netsecdevio/NeoCalculator/docs/UNIT_CATALOG_02_INVENTORY.md

# Generated unit inventory

Source: `src/math/units/registry.json`. IDs do not depend on order.

| ID | Symbol | English / Español | Kind | SI nominal scale and offset | Exactness | Source / location |
|---|---|---|---|---|---|---|
| 1 | m | Metre / Metro | length | [1, 1, 0, 0] ; offset [0, 1, 0, 0] | exact | bipm: §2.3.1, metre |
| 2 | g | Gram / Gramo | mass | [1, 1, -3, 0] ; offset [0, 1, 0, 0] | exact | bipm: §3, p.139, kilogram exception |
| 3 | s | Second / Segundo | time | [1, 1, 0, 0] ; offset [0, 1, 0, 0] | exact | bipm: §2.3.1, second |
| 4 | A | Ampere / Amperio | current | [1, 1, 0, 0] ; offset [0, 1, 0, 0] | exact | bipm: §2.3.1, ampere |
| 5 | K | Kelvin / Kelvin | temperature | [1, 1, 0, 0] ; offset [0, 1, 0, 0] | exact | bipm: §2.3.1, kelvin |
| 6 | mol | Mole / Mol | amount | [1, 1, 0, 0] ; offset [0, 1, 0, 0] | exact | bipm: §2.3.1, mole |
| 7 | cd | Candela / Candela | luminous_intensity | [1, 1, 0, 0] ; offset [0, 1, 0, 0] | exact | bipm: §2.3.1, candela |
| 8 | rad | Radian / Radián | angle | [1, 1, 0, 0] ; offset [0, 1, 0, 0] | exact | bipm: §2.3.4, Table 4 |
| 9 | sr | Steradian / Estereorradián | solid_angle | [1, 1, 0, 0] ; offset [0, 1, 0, 0] | exact | bipm: §2.3.4, Table 4 |
| 10 | Hz | Hertz / Hercio | frequency | [1, 1, 0, 0] ; offset [0, 1, 0, 0] | exact | bipm: §2.3.4, Table 4 |
| 11 | N | Newton / Newton | force | [1, 1, 0, 0] ; offset [0, 1, 0, 0] | exact | bipm: §2.3.4, Table 4 |
| 12 | Pa | Pascal / Pascal | pressure | [1, 1, 0, 0] ; offset [0, 1, 0, 0] | exact | bipm: §2.3.4, Table 4 |
| 13 | J | Joule / Julio | energy | [1, 1, 0, 0] ; offset [0, 1, 0, 0] | exact | bipm: §2.3.4, Table 4 |
| 14 | W | Watt / Vatio | power | [1, 1, 0, 0] ; offset [0, 1, 0, 0] | exact | bipm: §2.3.4, Table 4 |
| 15 | C | Coulomb / Culombio | charge | [1, 1, 0, 0] ; offset [0, 1, 0, 0] | exact | bipm: §2.3.4, Table 4 |
| 16 | V | Volt / Voltio | voltage | [1, 1, 0, 0] ; offset [0, 1, 0, 0] | exact | bipm: §2.3.4, Table 4 |
| 17 | F | Farad / Faradio | capacitance | [1, 1, 0, 0] ; offset [0, 1, 0, 0] | exact | bipm: §2.3.4, Table 4 |
| 18 | Ω | Ohm / Ohmio | resistance | [1, 1, 0, 0] ; offset [0, 1, 0, 0] | exact | bipm: §2.3.4, Table 4 |
| 19 | S | Siemens / Siemens | conductance | [1, 1, 0, 0] ; offset [0, 1, 0, 0] | exact | bipm: §2.3.4, Table 4 |
| 20 | Wb | Weber / Weber | magnetic_flux | [1, 1, 0, 0] ; offset [0, 1, 0, 0] | exact | bipm: §2.3.4, Table 4 |
| 21 | T | Tesla / Tesla | flux_density | [1, 1, 0, 0] ; offset [0, 1, 0, 0] | exact | bipm: §2.3.4, Table 4 |
| 22 | H | Henry / Henrio | inductance | [1, 1, 0, 0] ; offset [0, 1, 0, 0] | exact | bipm: §2.3.4, Table 4 |
| 23 | °C | Degree Celsius / Grado Celsius | temperature | [1, 1, 0, 0] ; offset [27315, 100, 0, 0] | exact | bipm: §2.3.4, Table 4 |
| 24 | lm | Lumen / Lumen | luminous_flux | [1, 1, 0, 0] ; offset [0, 1, 0, 0] | exact | bipm: §2.3.4, Table 4 |
| 25 | lx | Lux / Lux | illuminance | [1, 1, 0, 0] ; offset [0, 1, 0, 0] | exact | bipm: §2.3.4, Table 4 |
| 26 | Bq | Becquerel / Becquerel | activity | [1, 1, 0, 0] ; offset [0, 1, 0, 0] | exact | bipm: §2.3.4, Table 4 |
| 27 | Gy | Gray / Gray | absorbed_dose | [1, 1, 0, 0] ; offset [0, 1, 0, 0] | exact | bipm: §2.3.4, Table 4 |
| 28 | Sv | Sievert / Sievert | equivalent_dose | [1, 1, 0, 0] ; offset [0, 1, 0, 0] | exact | bipm: §2.3.4, Table 4 |
| 29 | kat | Katal / Katal | catalytic_activity | [1, 1, 0, 0] ; offset [0, 1, 0, 0] | exact | bipm: §2.3.4, Table 4 |
| 40 | in | Inch (international) / Pulgada internacional | length | [254, 1, -4, 0] ; offset [0, 1, 0, 0] | exact | nist811: Appendix B.8, named row; exact definition |
| 41 | ft | Foot (international) / Pie internacional | length | [3048, 1, -4, 0] ; offset [0, 1, 0, 0] | exact | nist811: Appendix B.8, named row; exact definition |
| 42 | yd | Yard (international) / Yarda internacional | length | [9144, 1, -4, 0] ; offset [0, 1, 0, 0] | exact | nist811: Appendix B.8, named row; exact definition |
| 43 | mi | Mile (international) / Milla internacional | length | [1609344, 1, -3, 0] ; offset [0, 1, 0, 0] | exact | nist811: Appendix B.8, named row; exact definition |
| 44 | nmi | Nautical mile / Milla náutica | length | [1852, 1, 0, 0] ; offset [0, 1, 0, 0] | exact | bipm: §4, Table 8, pp.140–141 |
| 45 | ha | Hectare / Hectárea | area | [1, 1, 4, 0] ; offset [0, 1, 0, 0] | exact | bipm: §4, Table 8, pp.140–141 |
| 46 | L | Litre / Litro | volume | [1, 1, -3, 0] ; offset [0, 1, 0, 0] | exact | bipm: §4, Table 8, pp.140–141 |
| 47 | min | Minute / Minuto | time | [60, 1, 0, 0] ; offset [0, 1, 0, 0] | exact | bipm: §4, Table 8, pp.140–141 |
| 48 | h | Hour / Hora | time | [3600, 1, 0, 0] ; offset [0, 1, 0, 0] | exact | bipm: §4, Table 8, pp.140–141 |
| 49 | d | Day / Día | time | [86400, 1, 0, 0] ; offset [0, 1, 0, 0] | exact | bipm: §4, Table 8, pp.140–141 |
| 50 | lb | Pound (avoirdupois) / Libra avoirdupois | mass | [45359237, 1, -8, 0] ; offset [0, 1, 0, 0] | exact | nist811: Appendix B.8, named row; exact definition |
| 51 | oz | Ounce (avoirdupois) / Onza avoirdupois | mass | [45359237, 16, -8, 0] ; offset [0, 1, 0, 0] | exact | nist811: Appendix B.8, named row; exact definition |
| 52 | t | Tonne / Tonelada | mass | [1, 1, 3, 0] ; offset [0, 1, 0, 0] | exact | bipm: §4, Table 8, pp.140–141 |
| 53 | atm | Standard atmosphere / Atmósfera estándar | pressure | [101325, 1, 0, 0] ; offset [0, 1, 0, 0] | exact | nist811: Appendix B.8, named row; exact definition |
| 54 | bar | Bar / Bar | pressure | [1, 1, 5, 0] ; offset [0, 1, 0, 0] | exact | bipm: §4, Table 8, pp.140–141 |
| 55 | psi | Pound-force per square inch / Libra-fuerza por pulgada cuadrada | pressure | [8896443230521, 1290320000, 0, 0] ; offset [0, 1, 0, 0] | exact | nist811: B.8 pound-force and inch; BIPM Appendix CGPM 1901, standard g |
| 56 | eV | Electronvolt / Electronvoltio | energy | [1602176634, 1, -28, 0] ; offset [0, 1, 0, 0] | exact | bipm: §4, Table 8, pp.140–141 |
| 57 | ° | Degree / Grado angular | angle | [1, 180, 0, 1] ; offset [0, 1, 0, 0] | exact | bipm: §4, Table 8, pp.140–141 |
| 58 | ′ | Arcminute / Minuto de arco | angle | [1, 10800, 0, 1] ; offset [0, 1, 0, 0] | exact | bipm: §4, Table 8, pp.140–141 |
| 59 | ″ | Arcsecond / Segundo de arco | angle | [1, 648000, 0, 1] ; offset [0, 1, 0, 0] | exact | bipm: §4, Table 8, pp.140–141 |
| 60 | °F | Degree Fahrenheit / Grado Fahrenheit | temperature | [5, 9, 0, 0] ; offset [45967, 180, 0, 0] | exact | nist_temperature: Exact conversion equations, Fahrenheit to kelvin |
| 61 | ΔK | Kelvin difference / Diferencia kelvin | temperature | [1, 1, 0, 0] ; offset [0, 1, 0, 0] | exact | nist_temperature: Temperature intervals |
| 62 | Δ°C | Celsius difference / Diferencia Celsius | temperature | [1, 1, 0, 0] ; offset [0, 1, 0, 0] | exact | nist_temperature: Temperature intervals |
| 63 | Δ°F | Fahrenheit difference / Diferencia Fahrenheit | temperature | [5, 9, 0, 0] ; offset [0, 1, 0, 0] | exact | nist_temperature: Temperature intervals |
| 64 | au | Astronomical unit / Unidad astronómica | length | [149597870700, 1, 0, 0] ; offset [0, 1, 0, 0] | exact | bipm: §4, Table 8, pp.140–141 |
| 65 | lbf | Pound-force / Libra-fuerza | force | [8896443230521, 2000000000000, 0, 0] ; offset [0, 1, 0, 0] | exact | nist811: B.8 pound-force; BIPM Appendix CGPM 1901, standard g |
| 1006 | mil | Mil / thou / Mil / thou | length | [127, 5, -6, 0] ; offset [0, 1, 0, 0] | exact | ucum22: [mil_i] |
| 1008 | ftm | International fathom / Braza internacional | length | [1143, 625, 0, 0] ; offset [0, 1, 0, 0] | exact | ucum22: [fth_i] |
| 1009 | cable | Cable (0.1 nmi) / Cable (0,1 nmi) | length | [926, 5, 0, 0] ; offset [0, 1, 0, 0] | exact | nist_foot: cable length185.2m |
| 1010 | cableUS | Cable (US, 720 ft) / Cable (EE. UU., 720 ft) | length | [27432, 125, 0, 0] ; offset [0, 1, 0, 0] | exact | nist_foot: cable720internationalfeet |
| 1011 | ch | International chain / Cadena internacional | length | [12573, 625, 0, 0] ; offset [0, 1, 0, 0] | exact | nist_foot: International foot-based relation; 66ft |
| 1012 | link | International link / Eslabón internacional | length | [12573, 625, -2, 0] ; offset [0, 1, 0, 0] | exact | nist_foot: International foot-based relation; 33/50ft |
| 1013 | rd | International rod / Rod internacional | length | [12573, 25, -2, 0] ; offset [0, 1, 0, 0] | exact | nist_foot: International foot-based relation; 33/2ft |
| 1014 | fur | International furlong / Furlong internacional | length | [25146, 125, 0, 0] ; offset [0, 1, 0, 0] | exact | nist_foot: International foot-based relation; 660ft |
| 1015 | hand | Equestrian hand / Mano ecuestre | length | [127, 125, -1, 0] ; offset [0, 1, 0, 0] | exact | ucum22: International foot-based relation; 1/3ft |
| 1016 | ft | US survey foot (historic) / Pie topográfico EE. UU. | length | [12, 3937, 2, 0] ; offset [0, 1, 0, 0] | exact | nist_foot: US survey foot1200/3937m; obsolete after2022 |
| 1018 | ly | Light-year (Julian) / Año luz (juliano) | length | [94607304725808, 1, 2, 0] ; offset [0, 1, 0, 0] | exact | ucum22: [ly]=[c].a_j |
| 1019 | pc | Parsec / Pársec | length | [969394202136, 1, 5, -1] ; offset [0, 1, 0, 0] | exact | iau2015: Note4 exact648000au/pi |
| 1020 | ls | Light-second / Segundo luz | length | [299792458, 1, 0, 0] ; offset [0, 1, 0, 0] | exact | bipm: Defining speed of light times1second |
| 1021 | Å | Angstrom / Ángstrom | length | [1, 1, -10, 0] ; offset [0, 1, 0, 0] | exact | nist811: angstrom |
| 1022 | pt | DTP point / Punto DTP | length | [127, 36, -4, 0] ; offset [0, 1, 0, 0] | exact | css4: Absolute length:1pt=1/72in |
| 1023 | pc | DTP pica / Pica DTP | length | [127, 3, -4, 0] ; offset [0, 1, 0, 0] | exact | css4: Absolute length:1pc=1/6in |
| 1024 | U | Rack unit / Unidad de rack | length | [889, 2, -4, 0] ; offset [0, 1, 0, 0] | exact | rack: Nominal1.75in rack height |
| 1025 | Fr | French / Charriere / French / Charrière | length | [1, 3, -3, 0] ; offset [0, 1, 0, 0] | exact | ucum22: [Ch]=mm/3; diameter, not area |
| 1027 | a | Are / Área | area | [1, 1, 2, 0] ; offset [0, 1, 0, 0] | exact | nist811: are100m²; hectare remains stable existing identity |
| 1029 | ac | International acre / Acre internacional | area | [316160658, 78125, 0, 0] ; offset [0, 1, 0, 0] | exact | nist_foot: International acre43560ft² |
| 1034 | b | Barn / Barnio | area | [1, 1, -28, 0] ; offset [0, 1, 0, 0] | exact | nist811: barn |
| 1035 | cmil | Circular mil / Circular mil | area | [16129, 1, -14, 1] ; offset [0, 1, 0, 0] | exact | ucum22: [cml_i]=pi/4*[mil_i]^2 |
| 1041 | gal | US liquid gallon / Galón líquido EE. UU. | volume | [473176473, 125, -9, 0] ; offset [0, 1, 0, 0] | exact | ucum22: [gal_us]=231in³ |
| 1042 | gal | Imperial gallon / Galón imperial | volume | [454609, 1, -8, 0] ; offset [0, 1, 0, 0] | exact | ucum22: [gal_br]=4.54609L |
| 1043 | qt | US liquid quart / Cuarto líquido EE. UU. | volume | [473176473, 5, -11, 0] ; offset [0, 1, 0, 0] | exact | ucum22: [qt_us] |
| 1044 | qt | Imperial quart / Cuarto imperial | volume | [454609, 4, -8, 0] ; offset [0, 1, 0, 0] | exact | ucum22: [qt_br] |
| 1045 | pt | US liquid pint / Pinta líquida EE. UU. | volume | [473176473, 1, -12, 0] ; offset [0, 1, 0, 0] | exact | ucum22: [pt_us] |
| 1046 | pt | Imperial pint / Pinta imperial | volume | [454609, 8, -8, 0] ; offset [0, 1, 0, 0] | exact | ucum22: [pt_br] |
| 1047 | fl oz | US fluid ounce / Onza líquida EE. UU. | volume | [473176473, 16, -12, 0] ; offset [0, 1, 0, 0] | exact | ucum22: [foz_us] |
| 1048 | fl oz | Imperial fluid ounce / Onza líquida imperial | volume | [454609, 16, -9, 0] ; offset [0, 1, 0, 0] | exact | ucum22: [foz_br] |
| 1049 | gi | US gill / Gill EE. UU. | volume | [473176473, 4, -12, 0] ; offset [0, 1, 0, 0] | exact | ucum22: [gil_us] |
| 1050 | gi | Imperial gill / Gill imperial | volume | [454609, 32, -8, 0] ; offset [0, 1, 0, 0] | exact | ucum22: [gil_br] |
| 1051 | gal | US dry gallon / Galón áridos EE. UU. | volume | [220244188543, 5, -13, 0] ; offset [0, 1, 0, 0] | exact | ucum22: [gal_wi]=[bu_us]/8 |
| 1052 | qt | US dry quart / Cuarto áridos EE. UU. | volume | [220244188543, 2, -14, 0] ; offset [0, 1, 0, 0] | exact | ucum22: [dqt_us] |
| 1053 | pt | US dry pint / Pinta áridos EE. UU. | volume | [220244188543, 4, -14, 0] ; offset [0, 1, 0, 0] | exact | ucum22: [dpt_us] |
| 1054 | bu | US bushel / Bushel EE. UU. | volume | [220244188543, 625, -10, 0] ; offset [0, 1, 0, 0] | exact | ucum22: [bu_us]=2150.42in³ |
| 1055 | bu | Imperial bushel / Bushel imperial | volume | [454609, 125, -5, 0] ; offset [0, 1, 0, 0] | exact | ucum22: [bu_br] |
| 1056 | pk | US peck / Peck EE. UU. | volume | [220244188543, 25, -12, 0] ; offset [0, 1, 0, 0] | exact | ucum22: [pk_us] |
| 1057 | pk | Imperial peck / Peck imperial | volume | [454609, 5, -7, 0] ; offset [0, 1, 0, 0] | exact | ucum22: [pk_br] |
| 1058 | bbl | Petroleum barrel / Barril de petróleo | volume | [9936705933, 625, -8, 0] ; offset [0, 1, 0, 0] | exact | ucum22: [bbl_us] |
| 1060 | board ft | Board foot / Pie tablar | volume | [18435447, 78125, -5, 0] ; offset [0, 1, 0, 0] | exact | ucum22: [bf_i]=144in³ |
| 1061 | cord | Cord (stacked wood) / Cord (madera apilada) | volume | [884901456, 244140625, 0, 0] ; offset [0, 1, 0, 0] | exact | ucum22: [cr_i] |
| 1062 | st | Stere (stacked wood) / Estéreo (madera apilada) | volume | [1, 1, 0, 0] ; offset [0, 1, 0, 0] | exact | ucum22: st |
| 1063 | register ton | Register ton (volume) / Tonelada de registro | volume | [55306341, 1953125, -1, 0] ; offset [0, 1, 0, 0] | exact | nist811: NIST register ton100ft³ |
| 1064 | tsp | US teaspoon / Cucharadita EE. UU. | cooking_volume | [157725491, 32, -12, 0] ; offset [0, 1, 0, 0] | exact | ucum22: [tsp_us] |
| 1065 | tbsp | US tablespoon / Cucharada EE. UU. | cooking_volume | [473176473, 32, -12, 0] ; offset [0, 1, 0, 0] | exact | ucum22: [tbs_us] |
| 1066 | cup | US customary cup / Taza habitual EE. UU. | cooking_volume | [473176473, 2, -12, 0] ; offset [0, 1, 0, 0] | exact | ucum22: [cup_us] |
| 1067 | tsp | Metric teaspoon (5mL) / Cucharadita métrica (5mL) | cooking_volume | [1, 2, -5, 0] ; offset [0, 1, 0, 0] | exact | fda1019: b5viii5mL convention |
| 1068 | tbsp | Metric tablespoon (15mL) / Cucharada métrica (15mL) | cooking_volume | [3, 2, -5, 0] ; offset [0, 1, 0, 0] | exact | fda1019: b5viii15mL convention |
| 1069 | tbsp | Australian tablespoon / Cucharada australiana | cooking_volume | [1, 5, -4, 0] ; offset [0, 1, 0, 0] | exact | cooking_au: Australian20mL convention |
| 1070 | cup | Metric cup (250mL) / Taza métrica (250mL) | cooking_volume | [1, 4, -3, 0] ; offset [0, 1, 0, 0] | exact | cooking_au: Metric250mL convention |
| 1071 | cup | FDA nutrition cup (240mL) / Taza FDA (240mL) | cooking_volume | [3, 125, -2, 0] ; offset [0, 1, 0, 0] | exact | fda1019: b5viii240mL |
| 1076 | wk | Week (7 days) / Semana (7 días) | time | [6048, 1, 2, 0] ; offset [0, 1, 0, 0] | exact | ucum22: wk=7d |
| 1077 | a | Julian year / Año juliano | time | [315576, 1, 2, 0] ; offset [0, 1, 0, 0] | exact | ucum22: a_j=365.25d |
| 1078 | shake | Shake / Shake | time | [1, 1, -8, 0] ; offset [0, 1, 0, 0] | exact | nist811: shake |
| 1083 | gon | Gon / gradian / Gon / grado centesimal | plane_angle | [1, 2, -2, 1] ; offset [0, 1, 0, 0] | exact | ucum22: gon |
| 1084 | rev | Revolution / turn / Vuelta / revolución | plane_angle | [2, 1, 0, 1] ; offset [0, 1, 0, 0] | exact | ucum22: circ=2pi rad |
| 1086 | deg² | Square degree (solid angle) / Grado cuadrado (ángulo sólido) | solid_angle | [1, 324, -2, 2] ; offset [0, 1, 0, 0] | exact | bipm: sr=rad²; (pi/180)²sr |
| 1090 | st | Stone (mass) / Stone (masa) | mass | [317514659, 5, -7, 0] ; offset [0, 1, 0, 0] | exact | ucum22: [stone_av] |
| 1091 | gr | Grain / Grano | mass | [6479891, 1, -11, 0] ; offset [0, 1, 0, 0] | exact | ucum22: [gr] |
| 1092 | ct | Metric carat / Quilate métrico | mass | [1, 5, -3, 0] ; offset [0, 1, 0, 0] | exact | ucum22: [car_m] |
| 1093 | ozt | Troy ounce / Onza troy | mass | [19439673, 625, -6, 0] ; offset [0, 1, 0, 0] | exact | ucum22: [oz_tr] |
| 1094 | lb t | Troy pound / Libra troy | mass | [58319019, 15625, -4, 0] ; offset [0, 1, 0, 0] | exact | ucum22: [lb_tr] |
| 1095 | dwt | Pennyweight / Pennyweight | mass | [19439673, 125, -8, 0] ; offset [0, 1, 0, 0] | exact | ucum22: [pwt_tr] |
| 1097 | sh tn | US short ton / Tonelada corta EE. UU. | mass | [45359237, 5, -4, 0] ; offset [0, 1, 0, 0] | exact | ucum22: [ston_av] |
| 1098 | lg tn | Imperial long ton / Tonelada larga imperial | mass | [317514659, 3125, -2, 0] ; offset [0, 1, 0, 0] | exact | ucum22: [lton_av] |
| 1099 | cwt | US hundredweight / Hundredweight EE. UU. | mass | [45359237, 1, -6, 0] ; offset [0, 1, 0, 0] | exact | ucum22: [scwt_av] |
| 1100 | cwt | Imperial hundredweight / Hundredweight imperial | mass | [317514659, 625, -4, 0] ; offset [0, 1, 0, 0] | exact | ucum22: [lcwt_av] |
| 1101 | q | Metric quintal (100kg) / Quintal métrico (100kg) | mass | [1, 1, 2, 0] ; offset [0, 1, 0, 0] | exact | nist811: 100kg named convention |
| 1102 | slug | Slug / Slug | mass | [8896443230521, 6096, -8, 0] ; offset [0, 1, 0, 0] | exact | nist811: lbf*s²/ft |
| 1103 | Da | Dalton / unified atomic mass / Dalton / masa atómica unificada | mass | [41513476723, 25, -36, 0] ; offset [0, 1, 0, 0] | measured | codata2022: atomic mass constant2022 |
| 1104 | eV/c² | Electronvolt per c squared / Electronvoltio dividido por c² | mass | [1602176634, 89875517873681764, -28, 0] ; offset [0, 1, 0, 0] | exact | bipm: eV/c² using exact c and elementary charge |
| 1114 | Gal | Gal / galileo / Gal / galileo | acceleration | [1, 1, -2, 0] ; offset [0, 1, 0, 0] | exact | ucum22: Gal=cm/s² |
| 1121 | dyn | Dyne / Dina | force | [1, 1, -5, 0] ; offset [0, 1, 0, 0] | exact | ucum22: dyn=g*cm/s² |
| 1122 | gf | Gram-force / Gramo-fuerza | force | [196133, 2, -7, 0] ; offset [0, 1, 0, 0] | exact | ucum22: gf=g*standard gravity |
| 1124 | ozf | Ounce-force / Onza-fuerza | force | [8896443230521, 32, -12, 0] ; offset [0, 1, 0, 0] | exact | ucum22: lbf/16 |
| 1125 | pdl | Poundal / Poundal | force | [17281869297, 125, -9, 0] ; offset [0, 1, 0, 0] | exact | ucum22: lb*ft/s² |
| 1126 | kip | Kip (1000lbf) / Kip (1000lbf) | force | [8896443230521, 2, -9, 0] ; offset [0, 1, 0, 0] | exact | nist811: kip1000lbf |
| 1127 | tf | Metric tonne-force / Tonelada-fuerza métrica | force | [196133, 2, -1, 0] ; offset [0, 1, 0, 0] | exact | nist811: 1000kgf |
| 1145 | at | Technical atmosphere / Atmósfera técnica | pressure | [196133, 2, 0, 0] ; offset [0, 1, 0, 0] | exact | ucum22: att=kgf/cm² |
| 1146 | Torr | Torr / Torr | pressure | [20265, 152, 0, 0] ; offset [0, 1, 0, 0] | exact | nist811: torr=atm/760 |
| 1147 | mmHg | Conventional millimetre Hg / Milímetro Hg convencional | pressure | [26664477483, 2, -8, 0] ; offset [0, 1, 0, 0] | exact | cldr_units: NIST B8 note12 + CLDR density13595.1kg/m³ and g_n; height1mm |
| 1148 | mH₂O | Conventional metre water / Metro agua convencional | pressure | [196133, 2, -1, 0] ; offset [0, 1, 0, 0] | exact | ucum22: m[H2O]=9.80665kPa |
| 1149 | inH₂O | Conventional inch water / Pulgada agua convencional | pressure | [24908891, 1, -5, 0] ; offset [0, 1, 0, 0] | exact | ucum22: [in_i'H2O] |
| 1150 | inHg | Conventional inch Hg / Pulgada Hg convencional | pressure | [3386388640341, 1, -9, 0] ; offset [0, 1, 0, 0] | exact | cldr_units: NIST B8 note12 + CLDR density13595.1kg/m³ and g_n; height1in |
| 1153 | Ba | Barye / Baria | pressure | [1, 1, -1, 0] ; offset [0, 1, 0, 0] | exact | nist811: dyn/cm² |
| 1156 | cal | Calorie (thermochemical) / Caloría termoquímica | energy | [523, 125, 0, 0] ; offset [0, 1, 0, 0] | exact | ucum22: cal_th=4.184J |
| 1157 | cal | Calorie (International Table) / Caloría Tabla Internacional | energy | [10467, 25, -2, 0] ; offset [0, 1, 0, 0] | exact | ucum22: cal_IT=4.1868J |
| 1158 | Btu_IT | Btu International Table / Btu Tabla Internacional | energy | [52752792631, 5, -7, 0] ; offset [0, 1, 0, 0] | exact | ucum22: [Btu_IT]=1.05505585262kJ |
| 1159 | Btu_th | Btu thermochemical / Btu termoquímica | energy | [23722880951, 225, -5, 0] ; offset [0, 1, 0, 0] | exact | nist811_notes: Footnote9: thermochemical calorie4.184J, pound453.59237g, Fahrenheit interval5/9K; exact relation |
| 1160 | erg | Erg / Ergio | energy | [1, 1, -7, 0] ; offset [0, 1, 0, 0] | exact | ucum22: erg=dyn*cm |
| 1163 | therm | Therm (US) / Therm (EE. UU.) | energy | [1054804, 1, 2, 0] ; offset [0, 1, 0, 0] | exact | nist811: B8 thermUS exact bold factor |
| 1164 | therm | Therm (EC) / Therm (CE) | energy | [105506, 1, 3, 0] ; offset [0, 1, 0, 0] | exact | nist811: B8 thermEC exact bold factor |
| 1165 | toe | Tonne oil equivalent / Tonelada equivalente petróleo | energy | [41868, 1, 6, 0] ; offset [0, 1, 0, 0] | exact | energy_uk: AnnexA statistical41.868GJ |
| 1166 | t TNT | Tonne TNT equivalent / Tonelada equivalente TNT | energy | [4184, 1, 6, 0] ; offset [0, 1, 0, 0] | exact | nist811: B8 tonTNT=4.184GJ |
| 1168 | hp | Mechanical horsepower / Horsepower mecánico | power | [37284993579113511, 5, -13, 0] ; offset [0, 1, 0, 0] | exact | ucum22: [HP]=550ft*lbf/s |
| 1169 | CV | Metric horsepower / Caballo de vapor métrico | power | [588399, 8, -2, 0] ; offset [0, 1, 0, 0] | exact | nist811: 75kgf*m/s |
| 1170 | hp | Electric horsepower (746W) / Horsepower eléctrico (746W) | power | [746, 1, 0, 0] ; offset [0, 1, 0, 0] | exact | nist811: B8 exact electrical horsepower746W |
| 1171 | hp | Boiler horsepower / Horsepower de caldera | power | [19619, 2, 0, 0] ; offset [0, 1, 0, 0] | conventional_approximate | nist811: B8 rounded boiler hp9809.50W |
| 1173 | TR | US refrigeration ton / Tonelada refrigeración EE. UU. | power | [52752792631, 15, -6, 0] ; offset [0, 1, 0, 0] | exact | nist811: 12000Btu_IT/h |
| 1176 | var | Var (reactive power) / Var (potencia reactiva) | reactive_power | [1, 1, 0, 0] ; offset [0, 1, 0, 0] | exact | bipm: Special name for reactive power; same SI dimension asW |
| 1180 | °R | Degree Rankine / Grado Rankine | temperature | [5, 9, 0, 0] ; offset [0, 1, 0, 0] | exact | ucum22: [degR]=5K/9 |
| 1181 | °Ré | Degree Reaumur / Grado Réaumur | temperature | [5, 4, 0, 0] ; offset [5463, 2, -1, 0] | exact | ucum22: [degRe] scale5/4K origin273.15K |
| 1190 | clo | Clo / Clo | thermal_insulance | [31, 2, -2, 0] ; offset [0, 1, 0, 0] | exact | nist811: B8 clo0.155m²K/W |
| 1191 | tog | Tog / Tog | thermal_insulance | [1, 1, -1, 0] ; offset [0, 1, 0, 0] | exact | tog_iom: tog |
| 1202 | tex | Tex / Tex | linear_mass | [1, 1, -6, 0] ; offset [0, 1, 0, 0] | exact | ucum22: tex=g/km |
| 1203 | den | Denier / Denier | linear_mass | [1, 9, -6, 0] ; offset [0, 1, 0, 0] | exact | ucum22: [den]=g/(9000m) |
| 1214 | P | Poise / Poise | dynamic_viscosity | [1, 1, -1, 0] ; offset [0, 1, 0, 0] | exact | ucum22: P=dyn*s/cm² |
| 1216 | St | Stokes / Stokes | kinematic_viscosity | [1, 1, -4, 0] ; offset [0, 1, 0, 0] | exact | ucum22: St=cm²/s |
| 1221 | D | Darcy (porous permeability) / Darcy (permeabilidad porosa) | permeability_porous | [1, 101325, -7, 0] ; offset [0, 1, 0, 0] | exact | usgs_darcy: p9: flow1cm³/s through1cm² of1cP fluid over1cm under1atm |
| 1238 | D | Debye (electric dipole) / Debye (dipolo eléctrico) | electric_dipole | [3335641, 1, -36, 0] ; offset [0, 1, 0, 0] | conventional_approximate | iupac_green: p18,40: debye approximate SI correspondence; no post2019 exact CGS conversion is asserted |
| 1240 | G | Gauss / Gauss | magnetic_flux_density | [1, 1, -4, 0] ; offset [0, 1, 0, 0] | exact | ucum22: G=1e-4T |
| 1242 | Mx | Maxwell / Maxwell | magnetic_flux | [1, 1, -8, 0] ; offset [0, 1, 0, 0] | exact | ucum22: Mx=1e-8Wb |
| 1244 | Oe | Oersted / Oersted | magnetic_field | [25, 1, 1, -1] ; offset [0, 1, 0, 0] | exact | ucum22: Oe=250/pi A/m |
| 1245 | A turn | Ampere turn (coil count) / Amperio vuelta (bobina) | magnetomotive_force | [1, 1, 0, 0] ; offset [0, 1, 0, 0] | exact | bipm: Coil-turn count is dimensionless; this is not angle rad/rev |
| 1246 | Gi | Gilbert / Gilbert | magnetomotive_force | [5, 2, 0, -1] ; offset [0, 1, 0, 0] | exact | ucum22: Gb=Oe*cm=2.5/pi A |
| 1250 | lbmol | Pound mole / Libra mol | amount | [45359237, 1, -5, 0] ; offset [0, 1, 0, 0] | exact | nist811: B8 pound-mole453.59237mol |
| 1258 | U | Enzyme activity unit / Unidad de actividad enzimática | catalytic_activity | [1, 6, -7, 0] ; offset [0, 1, 0, 0] | exact | iupac_enzyme: 1µmol/min; assay conditions required |
| 1260 | Ci | Curie / Curie | radioactivity | [37, 1, 9, 0] ; offset [0, 1, 0, 0] | exact | ucum22: Ci=37e9Bq |
| 1262 | rad | Rad (absorbed dose) / Rad (dosis absorbida) | absorbed_dose | [1, 1, -2, 0] ; offset [0, 1, 0, 0] | exact | ucum22: RAD=0.01Gy |
| 1264 | rem | Rem (equivalent dose) / Rem (dosis equivalente) | equivalent_dose | [1, 1, -2, 0] ; offset [0, 1, 0, 0] | exact | ucum22: REM=0.01Sv |
| 1266 | R | Roentgen / Roentgen | radiation_exposure | [129, 5, -5, 0] ; offset [0, 1, 0, 0] | exact | ucum22: R=2.58e-4C/kg |
| 1272 | fc | Foot-candle / Foot-candle | illuminance | [15625, 145161, 2, 0] ; offset [0, 1, 0, 0] | exact | nist811: lm/ft² |
| 1273 | ph | Phot / Phot | illuminance | [1, 1, 4, 0] ; offset [0, 1, 0, 0] | exact | nist811: B8 phot=10000lx; UCUM2.2 phot row rejected as inverted |
| 1275 | sb | Stilb / Stilb | luminance | [1, 1, 4, 0] ; offset [0, 1, 0, 0] | exact | ucum22: sb=cd/cm² |
| 1276 | L | Lambert / Lambert | luminance | [1, 1, 4, -1] ; offset [0, 1, 0, 0] | exact | ucum22: Lmb=cd/cm²/pi |
| 1277 | fL | Foot-lambert / Foot-lambert | luminance | [15625, 145161, 2, -1] ; offset [0, 1, 0, 0] | exact | nist811: 1/(pi*ft²)cd |
| 1284 | D | Dioptre (lens power) / Dioptría (lente) | lens_power | [1, 1, 0, 0] ; offset [0, 1, 0, 0] | exact | ucum22: [diop]=1/m |
| 1286 | bit | Bit / Bit | information | [1, 1, 0, 0] ; offset [0, 1, 0, 0] | exact | nist_binary: binary digit count |
| 1287 | B | Byte / octet (8 bits) / Byte / octeto (8 bits) | information | [8, 1, 0, 0] ; offset [0, 1, 0, 0] | exact | nist_binary: 1B=8bit |
| 1288 | nibble | Nibble (4 bits) / Nibble (4 bits) | information | [4, 1, 0, 0] ; offset [0, 1, 0, 0] | exact | nist_binary: Explicit4-bit grouping convention |
| 1291 | Bd | Baud (symbols per second) / Baudio (símbolos por segundo) | symbol_rate | [1, 1, 0, 0] ; offset [0, 1, 0, 0] | exact | ucum22: UCUM Bd=1/s; symbol count, never assumed bit count |
| 1292 | Sa | Sample count / Recuento de muestras | sample_count | [1, 1, 0, 0] ; offset [0, 1, 0, 0] | exact | bipm: Sample count per second |
| 1293 | frame | Frame count / Recuento de fotogramas | frame_count | [1, 1, 0, 0] ; offset [0, 1, 0, 0] | exact | bipm: Frame count per second; capture/render/display role required |
| 1294 | event | Event count / Recuento de eventos | event_count | [1, 1, 0, 0] ; offset [0, 1, 0, 0] | exact | bipm: Event count per minute; counted event required |
| 1295 | FLOP | Floating-point operation / Operación de coma flotante | flop_count | [1, 1, 0, 0] ; offset [0, 1, 0, 0] | exact | bipm: Counted floating-point operations per second; precision and counting policy required |
| 1296 | instr | Instruction count / Recuento de instrucciones | instruction_count | [1, 1, 0, 0] ; offset [0, 1, 0, 0] | exact | bipm: Instruction count per second; architecture/program required |
| 1297 | IO | I/O operation count / Recuento de operaciones E/S | io_count | [1, 1, 0, 0] ; offset [0, 1, 0, 0] | exact | bipm: I/O operations per second; size and workload required |
| 1302 | vara | Burgos vara (1852) / Vara de Burgos (1852) | length | [167181, 2, -5, 0] ; offset [0, 1, 0, 0] | historical | cem1852: p643 Castilla; correspondences rounded per p656 |
| 1303 | fanega | Castilian fanega area (1852) / Fanega castellana superficie (1852) | area | [64395617, 1, -4, 0] ; offset [0, 1, 0, 0] | historical | cem1852: p643 Castilla; correspondences rounded per p656 |
| 1304 | fanega | Castilian dry fanega (1852) / Fanega castellana áridos (1852) | volume | [55501, 1, -6, 0] ; offset [0, 1, 0, 0] | historical | cem1852: p643 Castilla; correspondences rounded per p656 |
| 1305 | cántara | Castilian wine cantara (1852) / Cántara castellana vino (1852) | volume | [16133, 1, -6, 0] ; offset [0, 1, 0, 0] | historical | cem1852: p643 Castilla; correspondences rounded per p656 |
| 1306 | arroba | Castilian oil arroba (1852) / Arroba castellana aceite (1852) | volume | [12563, 1, -6, 0] ; offset [0, 1, 0, 0] | historical | cem1852: p643 Castilla; correspondences rounded per p656 |
| 1307 | catty | Hong Kong catty / Catty de Hong Kong | mass | [30239491, 5, -7, 0] ; offset [0, 1, 0, 0] | exact | hk: Common catty conversion table |
| 1308 | tael | Hong Kong common-mass tael / Tael común de Hong Kong | mass | [30239491, 8, -8, 0] ; offset [0, 1, 0, 0] | exact | hk: 1tael=1/16catty; not gold-trade variant |
| 1309 | tsubo | Japanese tsubo / Tsubo japonés | area | [661157, 2, -5, 0] ; offset [0, 1, 0, 0] | conventional_approximate | jetro: Hiroshima property area conversion; rounded |
| 1310 | rai | Thai rai / Rai tailandés | area | [16, 1, 2, 0] ; offset [0, 1, 0, 0] | exact | thai_boi: 1rai1600m² |

Definitions: 202. Catalogue items: 314. Insertable offered variants: 3674. Official prefixes: 24 + neutral. Typed references: 58.

## Typed physical references and contextual scales

| Reference ID | Symbol | English / Español | Kind / exactness | Nominal / uncertainty | Formula or context | Source / location |
|---|---|---|---|---|---|---|
| 1 | c | Speed of light in vacuum / Velocidad de la luz en el vacío | physical_constant / exact | 299792458 / 0 | 299792458 m/s | codata2022: speed of light in vacuum |
| 2 | a₀ | Bohr radius / Radio de Bohr | physical_constant / measured | 5.29177210544e-11 / 8.2e-21 | hbar/(electron_mass*c*alpha) | codata2022: Bohr radius |
| 3 | mₑ | Electron mass / Masa del electrón | physical_constant / measured | 9.1093837139e-31 / 2.8e-40 | electron_mass | codata2022: electron mass |
| 4 | Eₕ | Hartree energy / Energía de Hartree | physical_constant / measured | 4.3597447222060e-18 / 4.8e-30 | 2*R_infinity*h*c | codata2022: Hartree energy / atomic unit of energy |
| 5 | ℏ/Eₕ | Atomic unit of time / Unidad atómica de tiempo | physical_constant / measured | 2.4188843265864e-17 / 2.6e-29 | hbar/hartree_energy | codata2022: atomic unit of time |
| 6 | ℏ | Reduced Planck constant / Constante de Planck reducida | physical_constant / exact | 1.054571817e-34 / 0 | 6.62607015e-34/(2*pi) J*s | codata2022: reduced Planck constant |
| 7 | ℓₚ | Planck length / Longitud de Planck | physical_constant / measured | 1.616255e-35 / 1.8e-40 | sqrt(hbar*G/c^3) | codata2022: Planck length |
| 8 | tₚ | Planck time / Tiempo de Planck | physical_constant / measured | 5.391247e-44 / 6.0e-49 | sqrt(hbar*G/c^5) | codata2022: Planck time |
| 9 | mₚ | Planck mass / Masa de Planck | physical_constant / measured | 2.176434e-8 / 2.4e-13 | sqrt(hbar*c/G) | codata2022: Planck mass |
| 10 | Fₚ | Planck force / Fuerza de Planck | physical_constant / derived | 1.210256e44 / 2.7e39 | c^4/G | codata2022: Derived from CODATA 2022 G; not a separately listed table entry |
| 11 | Eₚ | Planck energy / Energía de Planck | physical_constant / derived | 1.956082e9 / 2.2e4 | sqrt(hbar*c^5/G) | codata2022: Derived in joules from CODATA 2022 h,c,G; table also lists mass energy equivalent in GeV |
| 12 | Tₚ | Planck temperature / Temperatura de Planck | physical_constant / measured | 1.416784e32 / 1.6e27 | sqrt(hbar*c^5/G)/k_B | codata2022: Planck temperature |
| 13 | g₀ | Standard gravity / Gravedad estándar | physical_constant / exact | 9.80665 / 0 | 9.80665 m/s^2 | codata2022: standard acceleration of gravity |
| 14 | e | Elementary charge / Carga elemental | physical_constant / exact | 1.602176634e-19 / 0 | 1.602176634e-19 C | codata2022: elementary charge |
| 100 | 1 | Unit one / Unidad uno | scale / exact | context required / not a fixed measured value | 1 | bipm: 2.3.3 dimensionless quantities |
| 101 | % | Percent (ratio) / Porcentaje (relación) | scale / exact | context required / not a fixed measured value | 10^-2 | nist811ratios: 7.10.2 |
| 102 | ‰ | Per mille (ratio) / Por mil (relación) | scale / exact | context required / not a fixed measured value | 10^-3 | ucum: 28 dimensionless units |
| 103 | ppm | Parts per million / Partes por millón | scale / exact | context required / not a fixed measured value | 10^-6 | nist811ratios: 7.10.2 |
| 104 | dB | Decibel (ratio) / Decibelio (relación) | scale / contextual | context required / not a fixed measured value | 10*log10(P2/P1); 20*log10(A2/A1) only with the corresponding square law | ucum: 46 table20 |
| 105 | Np | Neper (amplitude ratio) / Neper (relación de amplitudes) | scale / contextual | context required / not a fixed measured value | ln(A2/A1); dB=20/ln(10)*Np for equivalent amplitude conventions | ucum: 46 table20 |
| 106 | dBm | Power level, 1 mW / Nivel de potencia, 1 mW | scale / contextual | context required / not a fixed measured value | 10*log10(P/(1e-3 W)) | aes_levels: decibel / 0 dBm |
| 107 | dBW | Power level, 1 W / Nivel de potencia, 1 W | scale / contextual | context required / not a fixed measured value | 10*log10(P/(1 W)) | ucum: 46 bel watt |
| 108 | dBV | Voltage level, 1 V RMS / Nivel de tensión, 1 V RMS | scale / contextual | context required / not a fixed measured value | 20*log10(V_rms/(1 V)) | aes_levels: decibel / 0 dBV |
| 109 | dBu | Voltage level, approximately 0.775 V / Nivel de tensión, aprox. 0.775 V | scale / contextual | context required / not a fixed measured value | 20*log10(V_rms/V_ref); V_ref approximately 0.775 V; historical sqrt(3/5) V convention | aes_levels: decibel / 0 dBu |
| 110 | dB SPL | Sound pressure level (air) / Nivel de presión sonora (aire) | scale / contextual | context required / not a fixed measured value | 20*log10(p_rms/(20e-6 Pa)) | ucum: 46 bel sound pressure |
| 111 | dB(A) | A-weighted sound level / Nivel sonoro ponderado A | contextual / contextual | context required / not a fixed measured value | A_weighting(frequency_spectrum, measurement_time_convention) | ucum: 46 note on A weighting |
| 112 | dBFS | Digital full-scale level / Nivel digital de escala completa | contextual / contextual | context required / not a fixed measured value | level relative to calibrated full-scale reference | aes17: FS and dBFS terminology |
| 113 | Ma | Mach number / Número Mach | contextual / contextual | context required / not a fixed measured value | v/local_speed_of_sound | nasa_mach: M=V/a |
| 114 | pH | pH (activity) / pH (actividad) | contextual / contextual | context required / not a fixed measured value | -log10(a(H+)) | iupac_ph: P04524 |
| 115 | °Bx | Degree Brix (sucrose) / Grado Brix (sacarosa) | contextual / contextual | context required / not a fixed measured value | pure sucrose mass fraction = Brix/100; mixtures require a refractometric model | oiml_brix: 3.1, 4.3, Annex D |
| 116 | SG | Specific gravity / Densidad relativa | contextual / contextual | context required / not a fixed measured value | density(sample,T1)/density(reference,T2) | eia_api: Specific-gravity reference in API definition |
| 117 | °API | API gravity (60 F/60 F) / Grado API (60 F/60 F) | scale / contextual | context required / not a fixed measured value | 141.5/SG_60F_60F - 131.5 | eia_api: API gravity equation |
| 118 | eq | Chemical equivalent / Equivalente químico | contextual / contextual | context required / not a fixed measured value | equivalent amount = reaction_equivalence_factor * amount_of_substance | ucum: 45 equivalents |
| 119 | N | Normality (chemistry) / Normalidad (química) | contextual / contextual | context required / not a fixed measured value | reaction_equivalents/litre | ucum: 45 equivalents, composed with litre |
| 120 | Osm | Osmole / Osmol | contextual / contextual | context required / not a fixed measured value | osmotically_active_particle_amount; depends on dissociation and nonideality | ucum: 45 osmol and caution on osmolar |
| 121 | IU | International unit (biological) / Unidad internacional (biológica) | contextual / contextual | context required / not a fixed measured value | substance-specific biological reference or assay | ucum: 45 international unit [iU] |
| 122 | NTU | Nephelometric turbidity (NTU) / Turbidez nefelométrica (NTU) | contextual / contextual | context required / not a fixed measured value | white-light nephelometric method | usgs_turbidity: 6.7.1.B and table6.7-4 |
| 123 | FNU | Formazin nephelometric turbidity (FNU) / Turbidez de formazina (FNU) | contextual / contextual | context required / not a fixed measured value | near-infrared nephelometric method | usgs_turbidity: 6.7.1.B and table6.7-4 |
| 124 | AWG | American Wire Gauge / Calibre americano AWG | contextual / contextual | context required / not a fixed measured value | ASTM B258 gauge specification; use its defined size lookup or formula | astm_awg: Scope1.1-1.2 |
| 125 | SWG | British Standard Wire Gauge / Calibre británico SWG | contextual / contextual | context required / not a fixed measured value | named SWG lookup; no numeric table loaded | bsi_swg: BS3737:1964 catalogue; table not imported |
| 126 | mesh | Mesh (sieve specification) / Mesh (especificación de tamiz) | contextual / contextual | context required / not a fixed measured value | opening depends on mesh standard and wire diameter | astm_mesh: Scope1.1,1.3 |
| 127 | dpi | Dots per inch / Puntos por pulgada | scale / contextual | context required / not a fixed measured value | printer dots per international inch | css4: 7.4 resolution |
| 128 | ppi | Pixels per inch / Píxeles por pulgada | scale / contextual | context required / not a fixed measured value | image pixels per international inch | css4: 7.4 resolution |
| 129 | px | CSS pixel / Píxel CSS | contextual / contextual | context required / not a fixed measured value | 1 CSS in = 96 CSS px; physical calibration is device-dependent | css4: 6.2 |
| 130 | em | CSS em / Em CSS | contextual / contextual | context required / not a fixed measured value | computed font size of the element (CSS rules apply) | css4: 6.1.1 |
| 131 | rem | CSS rem / Rem CSS | contextual / contextual | context required / not a fixed measured value | computed font size of the root element (CSS rules apply) | css4: 6.1.1 |
| 132 | month | Calendar month / Mes civil | contextual / contextual | context required / not a fixed measured value | duration depends on dates and calendar, with timezone where relevant | usno_calendar: Calendar introduction |
| 133 | year | Calendar year / Año civil | contextual / contextual | context required / not a fixed measured value | duration depends on dates and calendar, with timezone where relevant | usno_calendar: Calendar introduction |
| 134 | cycle | Clock cycle / Ciclo de reloj | contextual / contextual | context required / not a fixed measured value | period = 1/f for the specified clock frequency | nist_clock: Definition of period and frequency |
| 135 | jiffy | Jiffy (system-defined) / Jiffy (según sistema) | contextual / contextual | context required / not a fixed measured value | system-specific tick; on Linux determined by configured HZ | linux_timers: Jiffies and HZ |
| 136 | word | Word (architecture-defined) / Palabra (según arquitectura) | contextual / contextual | context required / not a fixed measured value | bit count defined by the architecture or format | coral_word: Architecture word-size table |
| 137 | Nm³ | Normal cubic metre of gas / Metro cúbico normal de gas | contextual / contextual | context required / not a fixed measured value | volume at explicitly selected gas reference conditions | iso_gas: Abstract: temperature, pressure, humidity |
| 138 | Sm³ | Standard cubic metre of gas / Metro cúbico estándar de gas | contextual / contextual | context required / not a fixed measured value | volume at explicitly selected gas reference conditions | iso_gas: Abstract: temperature, pressure, humidity |
| 139 | scf | Standard cubic foot of gas / Pie cúbico estándar de gas | contextual / contextual | context required / not a fixed measured value | volume at explicitly selected gas reference conditions | iso_gas: Abstract: temperature, pressure, humidity |
| 140 | psia | Absolute pressure in psi / Presión absoluta en psi | contextual / contextual | context required / not a fixed measured value | p_absolute = p_gauge + p_reference | nist_pressure: Gauge and absolute modes |
| 141 | psig | Gauge pressure in psi / Presión manométrica en psi | contextual / contextual | context required / not a fixed measured value | p_absolute = p_gauge + p_reference | nist_pressure: Gauge and absolute modes |
| 142 | bar(a) | Absolute pressure in bar / Presión absoluta en bar | contextual / contextual | context required / not a fixed measured value | p_absolute = p_gauge + p_reference | nist_pressure: Gauge and absolute modes |
| 143 | bar(g) | Gauge pressure in bar / Presión manométrica en bar | contextual / contextual | context required / not a fixed measured value | p_absolute = p_gauge + p_reference | nist_pressure: Gauge and absolute modes |
## Sources

- bipm: [9th edition, V4.01, June 2026](https://www.bipm.org/en/si-brochure-9). SI defining constants; dimensionless quantities
- bipm_prefixes: [24 prefixes; CGPM 2022 additions, verified 2026-10-02](https://www.bipm.org/en/measurement-units/si-prefixes). SI prefixes table
- cem: [9th edition Spanish translation, preface December 2019](https://www.cem.es/sites/default/files/documentos/2022-08/30362_elsistemainternacionaldeunidades_web_0.pdf). Tables 2, 4 and 8; Spanish terminology only, not current prefix coverage
- nist811: [SP 811 (2008); stable conventional non-SI definitions only](https://www.nist.gov/pml/special-publication-811/nist-guide-si-appendix-b-conversion-factors/nist-guide-si-appendix-b8).
- nist_temperature: [Exact conversion equations, consulted 2026-10-02](https://www.nist.gov/pml/owm/si-units-temperature).
- nist_spelling: [SP 811, chapter 9; web revision 2025-08-18](https://www.nist.gov/pml/special-publication-811/nist-guide-si-chapter-9-rules-and-style-conventions-spelling-unit-names). 9.3: customary kilohm and megohm spellings
- nist811_notes: [SP8112008 footnotes, consulted2026-10-03](https://www.nist.gov/pml/special-publication-811/nist-guide-si-footnotes). Notes9,12,14,17,22,23,24
- usgs_darcy: [USGS Water-Supply Paper887 (1940)](https://pubs.usgs.gov/wsp/0887/report.pdf). p9 permeability unit4, Wyckoff et al.1933 definition
- cldr_units: [Unicode CLDR unit relationships, consulted2026-10-03](https://github.com/unicode-org/cldr/blob/main/common/supplemental/units.xml). ofhg density13595.1kg/m³ times standardgravity; conventionalHg relation
- tog_iom: [IOM synthetic blanket technical specifications](https://www.iom.int/sites/g/files/tmzbdl486/files/annex_1bis_-_iom_synthetic_blanket_h_technical_specifications_and_aql.pdf). Thermal resistance testing;1tog=0.1m²K/W
- iupac_green: [IUPAC Green Book4th edition abridged2025](https://iupac.org/wp-content/uploads/2025/03/IUPAC-GB4Abridged.pdf). p18 legacy unit Debye
- ucum22: [UCUM 2.2, 2024-06-17](https://ucum.org/ucum). §4 terminal unit tables
- nist_foot: [Revised factors; US survey foot retired after 2022](https://www.nist.gov/pml/us-surveyfoot/revised-unit-conversion-factors). International and US survey foot tables
- css4: [W3C Working Draft, 2024-03-12](https://www.w3.org/TR/2024/WD-css-values-4-20240312/). 6.1.1, 6.2 and 7.4
- iau2015: [IAU 2015 Resolution B2](https://arxiv.org/abs/1510.06262). Explanatory note 4: parsec = (648000/pi) au
- fda1019: [21 CFR101.9, current consulted 2026-10-03](https://www.ecfr.gov/current/title-21/chapter-I/subchapter-B/part-101/subpart-A/section-101.9). §101.9(b)(5)(viii): cup240mL,tablespoon15mL,teaspoon5mL
- cem1852: [Real Orden9December1852, compilation Madrid1858](https://www.cem.es/sites/default/files/2019-11/00000458recurso.pdf). p643, Castilla; final p656 rounding note
- codata2022: [2022 CODATA adjustment](https://physics.nist.gov/cuu/Constants/Table/allascii.txt). Named entries in the complete recommended-values table
- rack: [Dell technical documentation, consulted2026-10-03](https://www.dell.com/support/kbdoc/en-rs/000144807/me4-locating-the-service-tag). Rack unit1.75in; nominal height
- cooking_au: [Publisher recipe convention, consulted2026-10-03](https://www.nigella.com/ask/weights-and-measures-for-australia). Australian tablespoon20mL; metric cup250mL
- energy_uk: [UK government energy statistics annex](https://assets.publishing.service.gov.uk/media/5a81d77fe5274a2e87dbfc46/Annex_A-D.pdf). AnnexA, tonne oil equivalent41.868GJ
- tog: [Manufacturer thermal-rating documentation](https://www.heatholders.com/pages/what-is-a-tog-rating). 1tog=0.1m²K/W
- iupac_enzyme: [IUPAC Gold Book](https://goldbook.iupac.org/terms/view/I03114). International unit, enzyme activity1µmol/min
- nist_binary: [NIST binary multiples, consulted2026-10-03](https://physics.nist.gov/cuu/Units/binary.html). byte8bits; decimal and binary prefixes are distinct
- hk: [Chinese Medicine Council of Hong Kong, wholesale guide](https://www.cmchk.org.hk/pcm/pdf/guide_whole_chm_bfver_c.pdf). Weights conversion appendix: catty0.60478982kg; tael1/16catty
- jetro: [JETRO 2013 business survey](https://www.jetro.go.jp/ext_images/en/reports/survey/pdf/2013_05_01_biz.pdf). Hiroshima office-rent table: tsubo3.305785m²
- thai_boi: [Thailand National Statistical Office, 1985 Marine Fishery Census](https://www.nso.go.th/nsoweb/storage/ebook/2023/20230509185951_10500.pdf). Printed p26, section1.7 Measures and Symbols:1rai=1600m²=0.16ha
- nist811ratios: [SP 811, 2008](https://www.nist.gov/pml/special-publication-811/nist-guide-si-chapter-7-rules-and-style-conventions-expressing-values). 7.10 and 7.10.2
- ucum: [2.2, 2024-06-17](https://ucum.org/ucum). 43-48; tables 19-22
- nasa_mach: [NASA Glenn educational page, accessed 2026-10-03](https://www.grc.nasa.gov/www/k-12/airplane/mach.html). Mach number M=V/a
- iupac_ph: [Gold Book 5.0.0 (2025)](https://goldbook.iupac.org/terms/view/P04524). P04524, pH
- oiml_brix: [OIML R142-1:2025](https://www.oiml.org/en/files/pdf_r/r142-1-e25.pdf). 3.1, 4.3, Annex D
- eia_api: [EIA glossary, accessed 2026-10-03](https://www.eia.gov/tools/glossary/index.php?id=API_gravity). API gravity
- aes_levels: [AES Pro Audio Reference, accessed 2026-10-03](https://aes.org/publications/par/d/). decibel / dBu / dBV / dBm / dBFS
- aes17: [AES17 indexed public preview; revision not verified; accessed 2026-10-03](https://www.aes.org/publications/standards/preview.cfm?ID=21). Foreword and full-scale terminology
- usgs_turbidity: [USGS NFM 6.7, version 2.1, 2005-09](https://pubs.usgs.gov/twri/twri9a6/twri9a67/twri9a_Section6.7_v2.1.pdf). 6.7.1.B and table 6.7-4
- astm_awg: [ASTM B258-18(2026), public scope only](https://store.astm.org/standards/b258). Scope 1.1-1.2
- linux_timers: [Linux kernel documentation, accessed 2026-10-03](https://cdn.kernel.org/doc/html/latest/timers/hrtimers.html). Design notes concerning jiffies and HZ
- iso_gas: [ISO13443:1996; confirmed 2025; public abstract](https://www.iso.org/standard/20461.html). Abstract
- nist_pressure: [NIST instrument description, accessed 2026-10-03](https://www.nist.gov/laboratories/tools-instruments/piston-gauges-and-pressure-transducers). Gauge and absolute modes
- bsi_swg: [BS3737:1964 (withdrawn), public catalogue](https://knowledge.bsigroup.com/products/guide-to-series-of-basic-sizes-for-metal-sheet-strip-and-wire). Standard identity and scope
- astm_mesh: [ASTM E11-24, public scope](https://store.astm.org/e0011-24.html). Scope1.1 and1.3
- usno_calendar: [US Naval Observatory calendar introduction, accessed 2026-10-03](https://aa.usno.navy.mil/faq/calendars). Introduction; Gregorian and lunar calendars
- nist_clock: [NIST frequency glossary, sourced to IR8323r1; accessed 2026-10-03](https://csrc.nist.gov/glossary/term/frequency). Definition
- coral_word: [Coral RISC-V instruction guide, accessed 2026-10-03](https://developers.google.com/coral/guides/hardware/riscv-instr-set). Word-size table
- intel_word: [Intel Technology Journal Q3 1997](https://www.intel.com/content/dam/www/public/us/en/documents/research/1997-vol01-iss-3-intel-technology-journal.pdf). MMX instruction table, words and doublewords
- request_context: [User attachment 2026-10-03](None). Section 2

## Deferred

- dalton: Measured mass: uncertainty policy required.
- gallons, calories, horsepower: Variant catalogue deferred; avoid ambiguous names and rounded exactness.
- calendar months and years: No universal fixed duration; convention selector deferred.
- neper, bel, decibel: Logarithmic transformation support deferred.
- astronomical arcsecond prefixes: Standard mas, µas and pas are validated and formatted with as; the first catalogue offers only the neutral arcsecond.
- prefixed absolute Celsius: SI permits prefixes; the first catalogue offers neutral Celsius and explicit temperature differences pending affine quantity semantics.
