netsecdevio/NeoCalculator/hardware/pcb/neocalculator-bom.xlsx

Comment | Designator | Footprint | JLCPCB Part #（optional）
10uF / CL10A106MO8NQNC | C1,C2,C8,C9,C10 | C0603 | C92487
0.1uF / CL10B104KB8NNNC | C3,C5,C6,C7 | C0603 | C1591
22uF/16V / CL10A226MO7JZNC | C4 | C0603 | C2762594
ZX-MX1.25-2PWT | CN1 | CONN-SMD_2P-P1.25_MEGASTAR_ZX-MX1.25-2PWT | C7430468
1N4148WS | D1,D2,D3,D4,D5,D6,D7,D8,D9,D10,D11,D12,D13,D14,D15,D16,D17,D18,D19,D20,D21,D22,D23,D24,D25,D26,D27,D28,D29,D30,D31,D32,D33,D34,D35,D36,D37,D38,D39,D40,D41,D42,D43,D44,D45,D46,D47,D48,D49,D50 | SOD-323_L1.7-W1.3-LS2.5-FD | C7420319
H5VL10B | D51,D52 | SOD-882_L1.0-W0.6-BI | C7420372
SS14L | D53,D54 | SOD-123F_L2.8-W1.8-LS3.7-RD | C190475
FPC-05FB-40PH20 | FPC1 | FPC-SMD_40P-P0.50_XUNPU_FPC-05FB-40PH20 | C2856837
TS-1088-AR02016 | K1,K2 | SW-SMD_L3.9-W3.0-P4.45 | C720477
2.2uH / CMH160808B2R2MT | L1 | L0603 | C394950
XL-1608PGC-06 | LED1 | LED0603-RD_RED | C7371905
XL-1608SURC-06 | LED2 | LED0603-RD_RED | C965799
8205A | Q1 | TSSOP-8_L4.4-W3.0-P0.65-LS6.4-BL | C5148694
S8050 | Q2 | SOT-23-3_L2.9-W1.3-P1.90-LS2.4-BR | C20069125
1K / FRC0603F1001TS | R1,R2,R12,R18,R20,R21 | R0603 | C2907002
2.4K / FRC0603F2401TS | R4 | R0603 | C2907007
10K / RT0603BRD0710KL | R3,R9,R10,R11,R22 | R0603 | C95204
5.1K / FRC0603F5101TS | R5,R8 | R0603 | C2907044
0R / FRC0603F0000TS | R6,R7 | R0603 | C2906974
100R / RT0603BRD07100RL | R13 | R0603 | C122970
487K / ERJ2RKF4873X | R14 | R0402 | C416552
86.6K / ERJ2RKF8662X | R15 | R0402 | C2076776
100K / RT0402BRD07100KL | R16,R17 | R0402 | C852472
10R / FRC0603J100TS | R19 | R0603 | C2907091
MK-12C02-G020 | SW1 | SW-SMD_MK-12C02-G020 | C963206
TS-1187S-20 | SW2,SW3,SW4,SW5,SW6,SW7,SW8,SW9,SW10,SW11,SW12,SW13,SW14,SW15,SW16,SW17,SW18,SW19,SW20,SW21,SW22,SW23,SW24,SW25,SW26,SW27,SW28,SW29,SW30,SW31,SW32,SW33,SW34,SW35,SW36,SW37,SW38,SW39,SW40,SW41,SW42,SW43,SW44,SW45,SW46,SW47,SW48,SW49,SW50,SW51 | SW-SMD_4P-L5.1-W5.1-P3.70-LS6.4 | C19779060
TP4056 | U1 | ESOP-8_L4.9-W3.9-P1.27-LS6.0-BL-EP | C382139
ESP32-S3-WROOM-1U-N16R8 | U2 | WIRELM-SMD_ESP32-S3-WROOM-1U | C3013946
DW01HA. / FM | U3 | SOT-23-6_L2.9-W1.6-P0.95-LS2.8-BR | C49340405
RT6150AGQW | U4 | WDFN-10_L3.0-W3.0-P0.50-BL-EP | C147971
MC-121-L124 | USB1 | USB-C-SMD_HANBO_MC-121-L124 | C6332279
