netsecdevio/NeoCalculator/hardware/enclosure/display-shim.stl

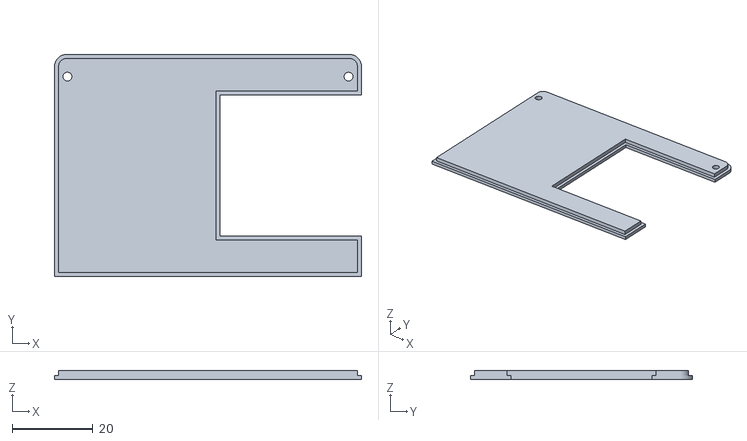
[picture p1: CAD file, 2026-11-02]
hardware/enclosure/display-shim.stl
76.0 x 55.0 x 2.20
