netsecdevio/NeoCalculator/hardware/enclosure/case-top.stl

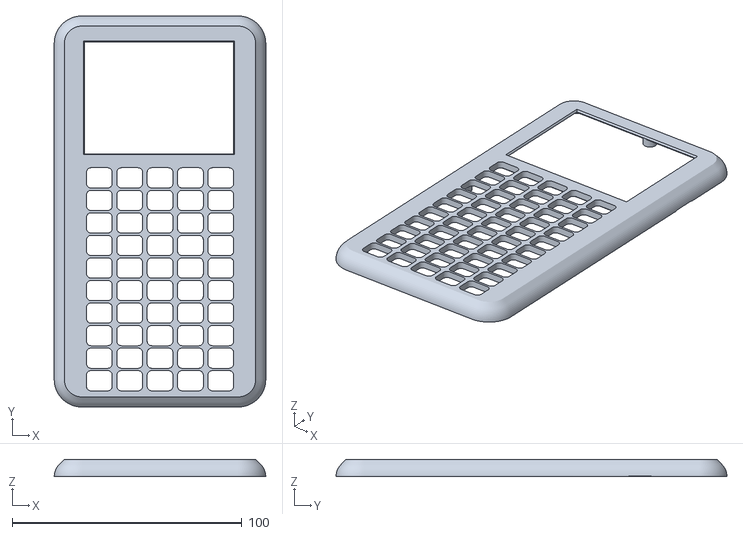
[picture p2: CAD file, 2026-11-02]
hardware/enclosure/case-top.stl
92.0 x 170.0 x 7.50
