netsecdevio/NeoCalculator/hardware/enclosure/switch-slider.stl

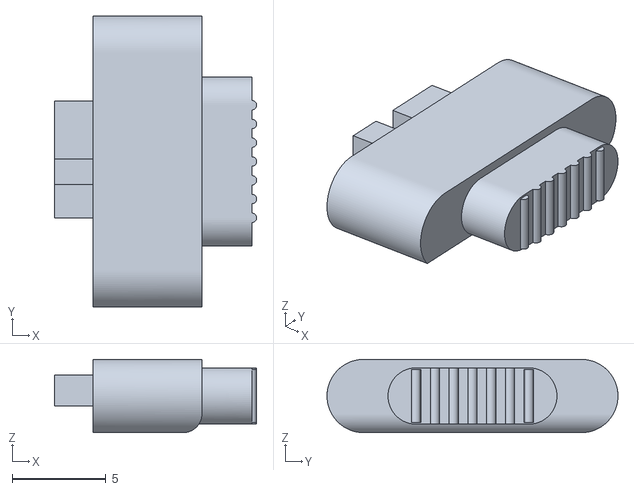
[picture p3: CAD file, 2026-11-02]
hardware/enclosure/switch-slider.stl
10.8 x 15.5 x 3.90
