netsecdevio/NeoCalculator/hardware/enclosure/case-bottom.stl

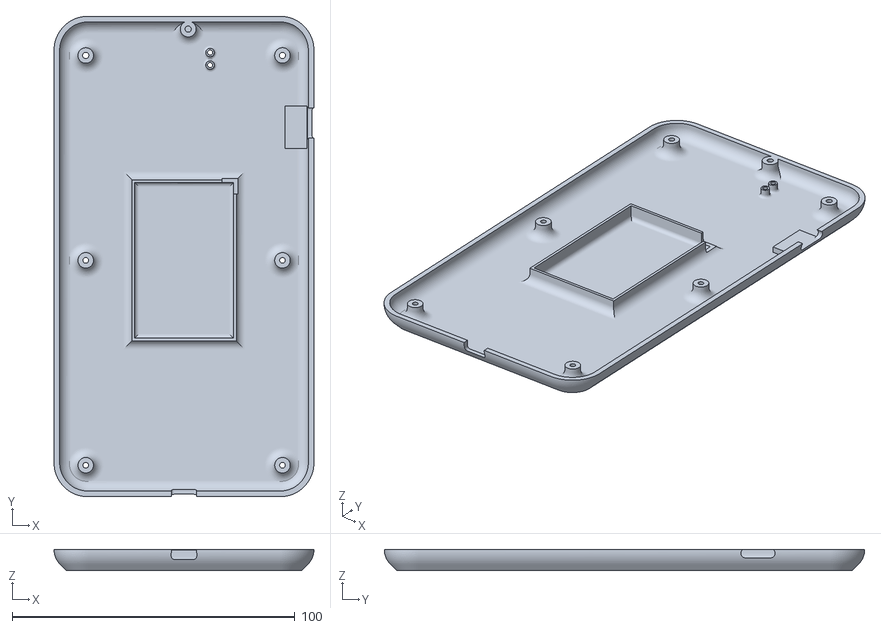
[picture p4: CAD file, 2026-11-02]
hardware/enclosure/case-bottom.stl
92.0 x 170.0 x 7.50
