netsecdevio/NeoCalculator/hardware/enclosure/key.stl

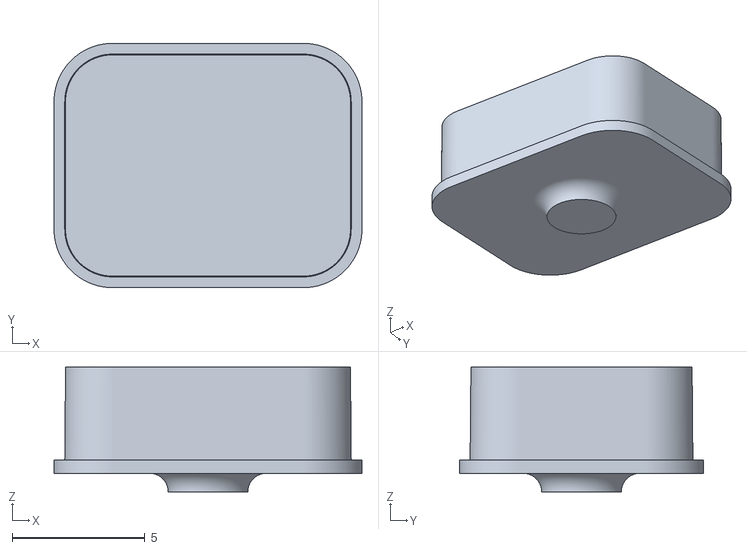
[picture p5: CAD file, 2026-11-02]
hardware/enclosure/key.stl
11.6 x 9.20 x 4.70
