netsecdevio/NeoCalculator/hardware/pcb/neocalculator-schematic.pdf

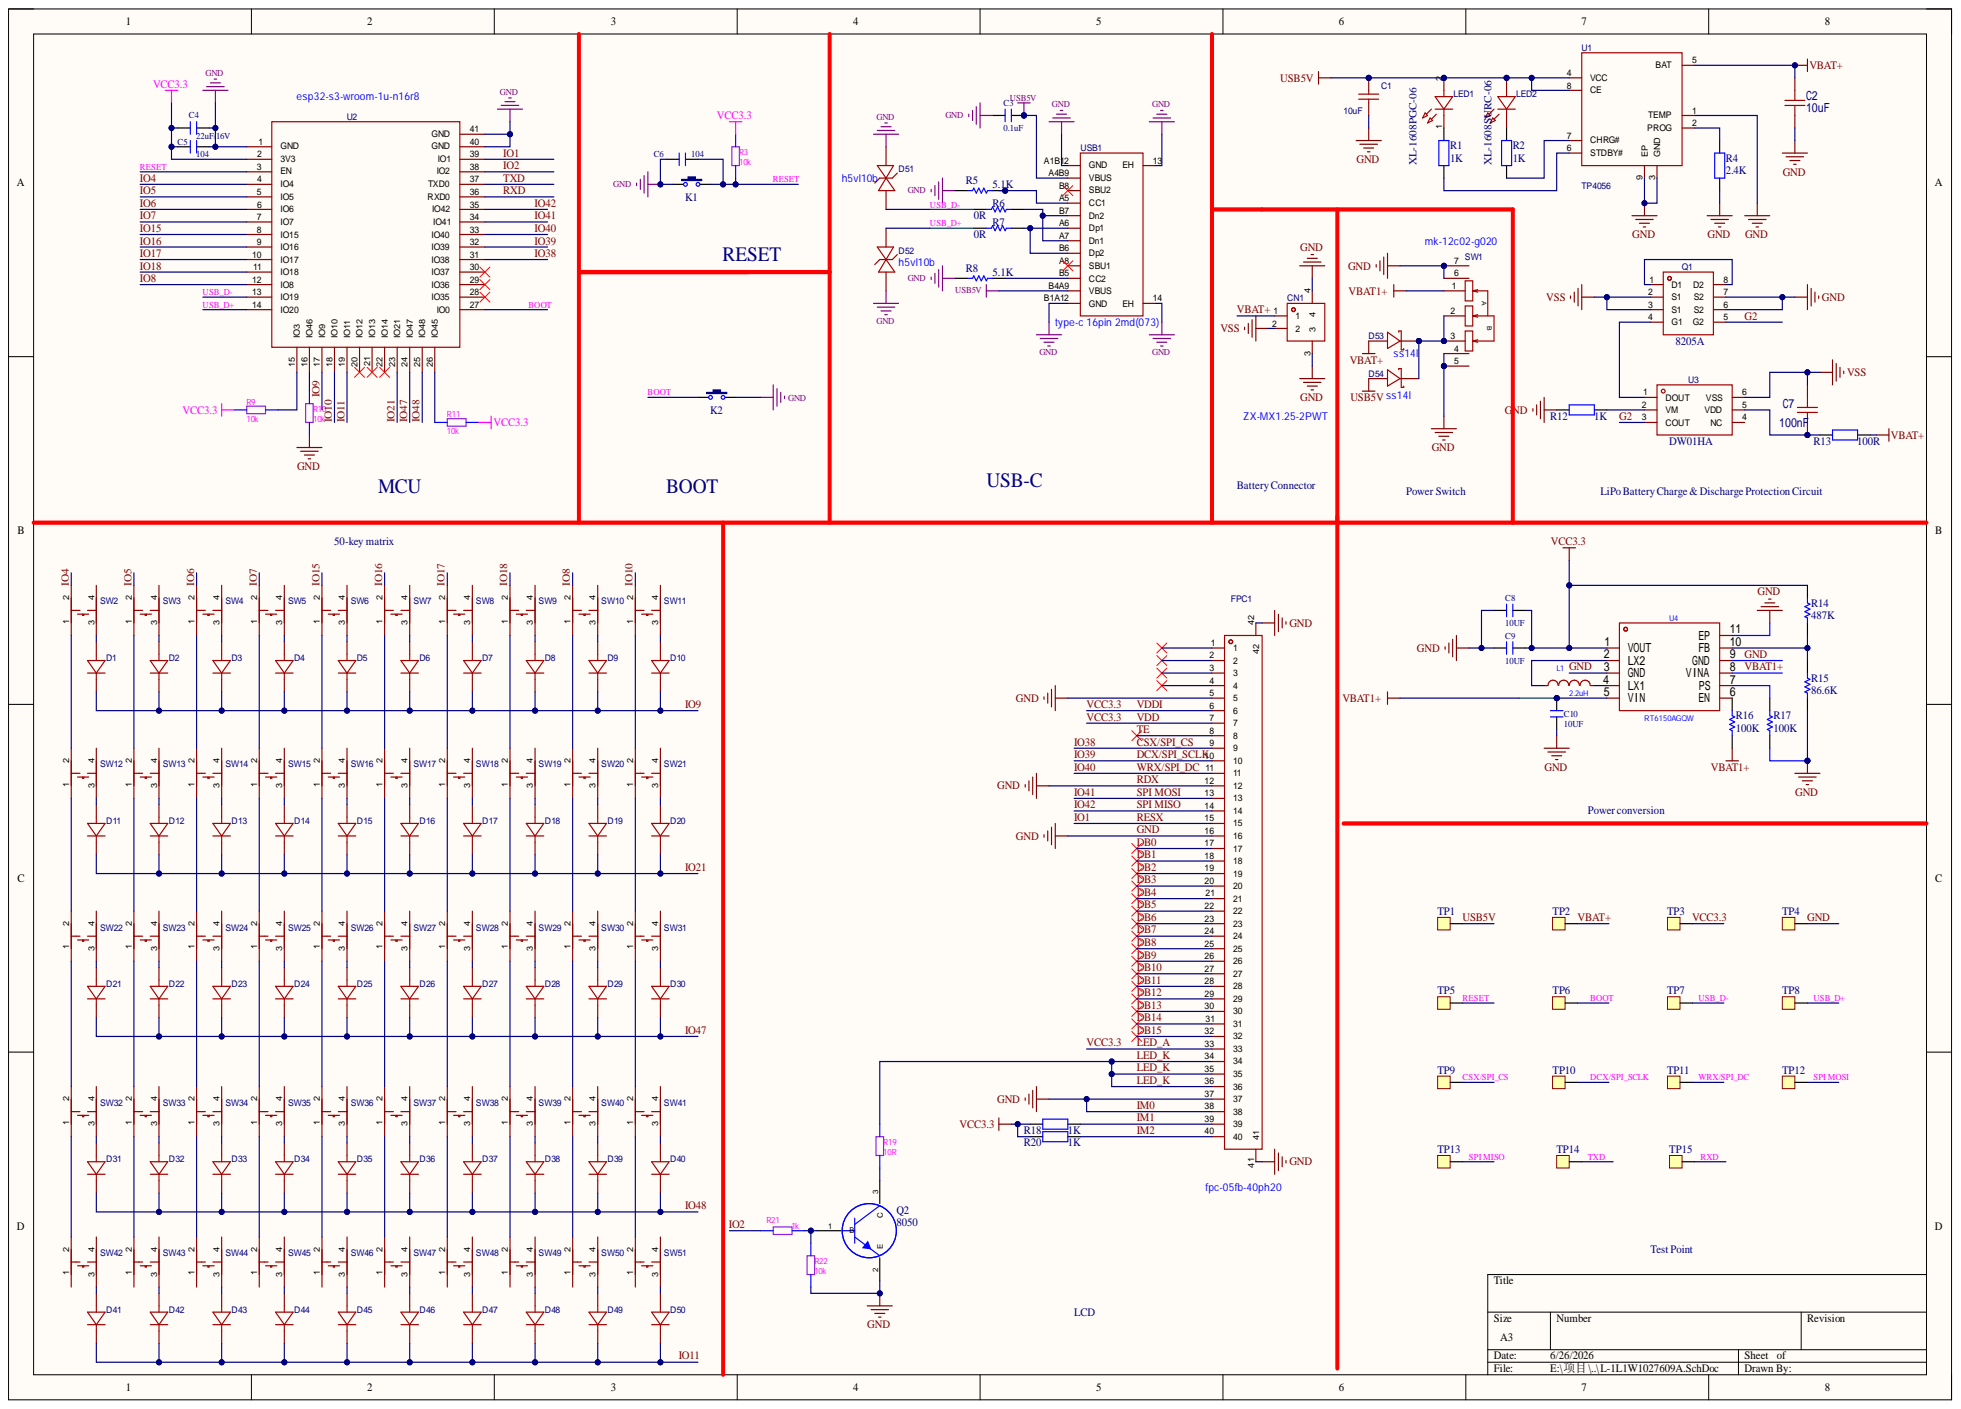
[picture p6: page 1]

LED_K | 35 35
LED_K | 36 36
