netsecdevio/NeoCalculator/hardware/pcb/neocalculator-board-outline.pdf

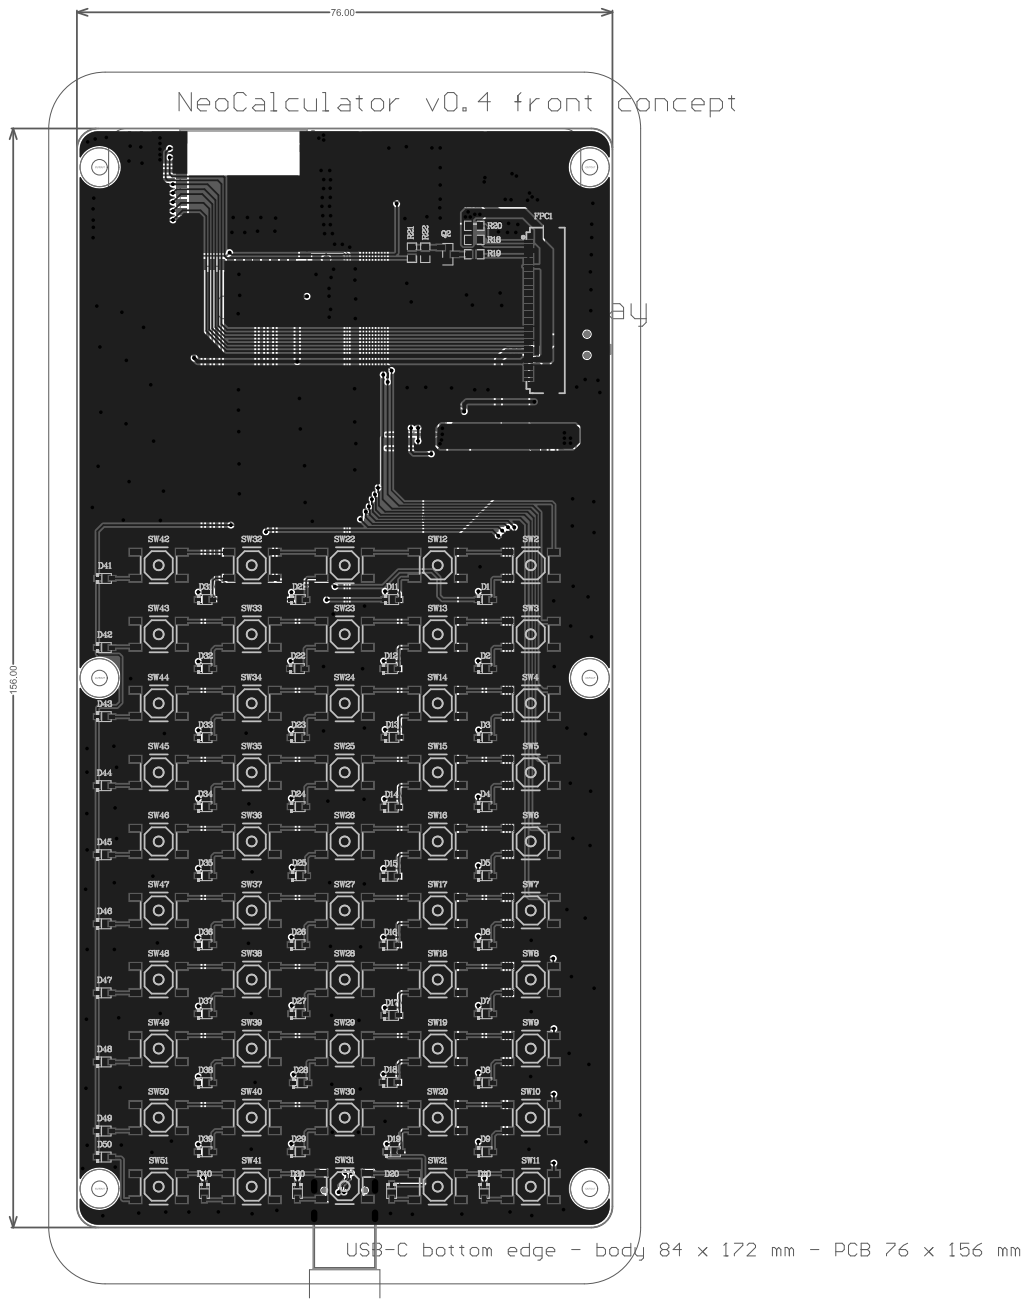
[picture p7: page 1]
