netsecdevio/NeoCalculator/hardware/pcb/neocalculator.kicad_pcb

## KiCad design hardware/pcb/neocalculator.kicad_pcb (2026-11-02)

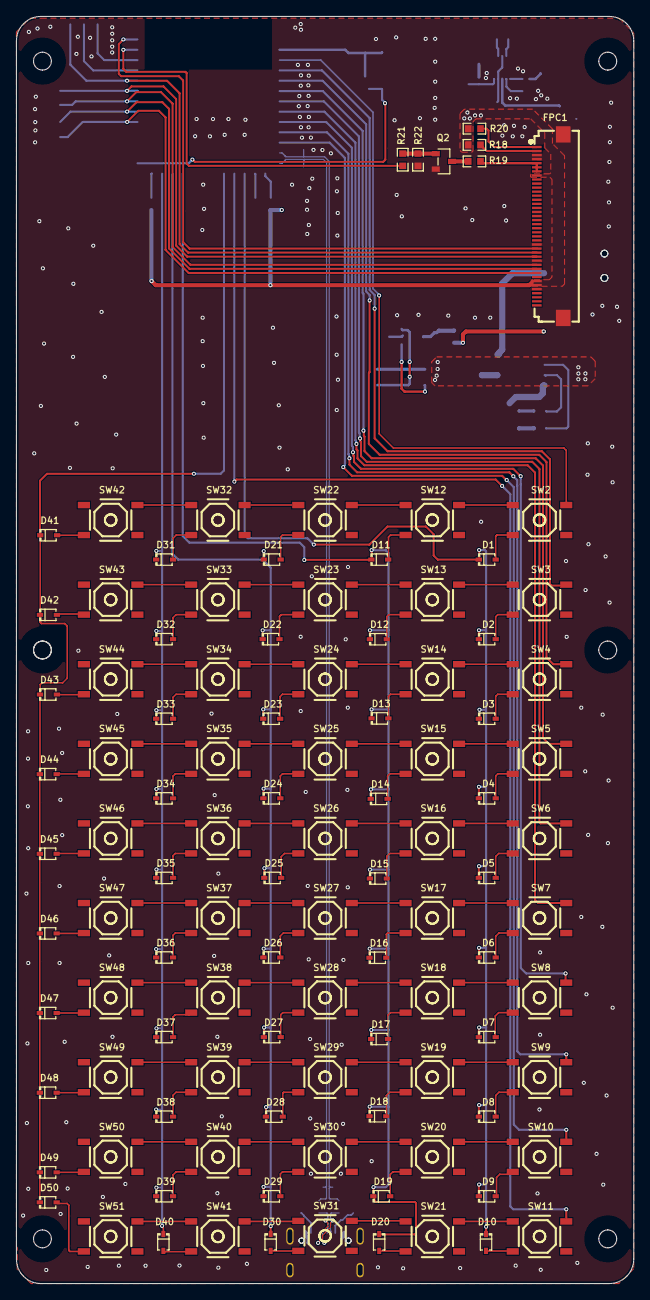
[picture p8: board neocalculator.kicad_pcb from above]

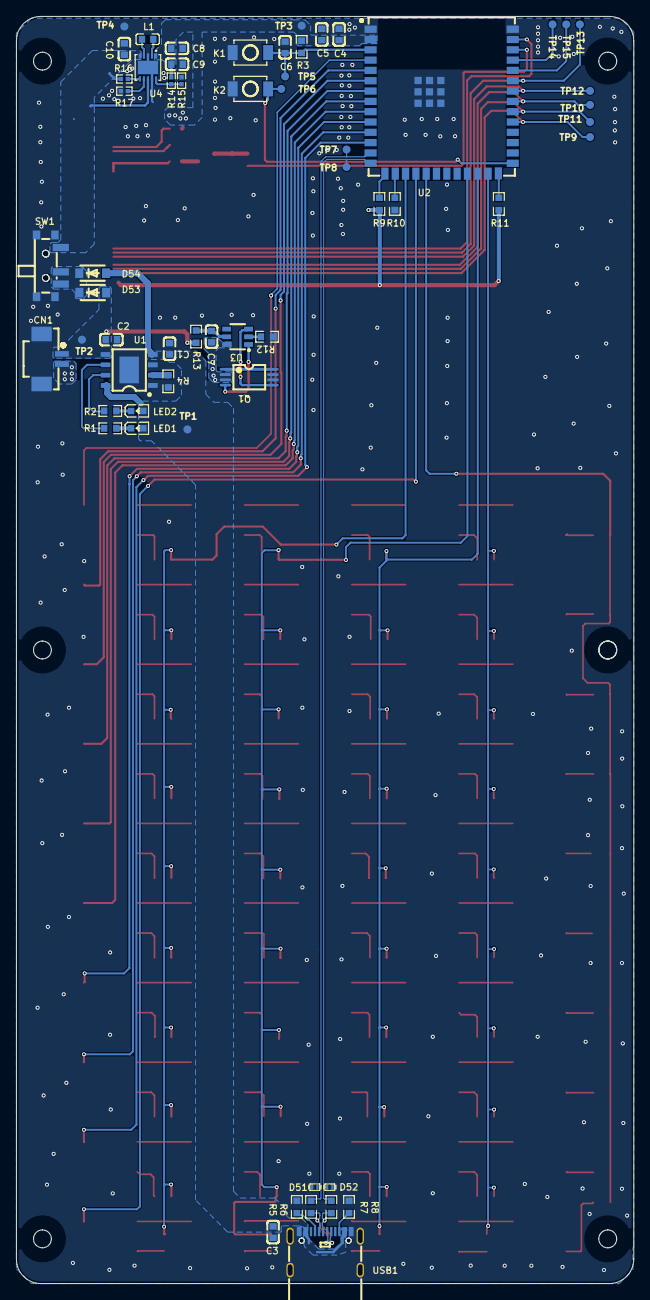
[picture p9: board neocalculator.kicad_pcb from below]

Board: 2 copper layers, 76.0 x 156.0 mm, 166 parts (59 on the bottom side), 152 nets.

Parts:
C1, C2: 10uF; C0603
C3: 0.1uF; C0603
C4: 22uF/16V; C0603
C5, C6: 104; C0603
C7: 100nF; C0603
C8, C9, C10: 10UF; C0603
CN1: ZX-MX1.25-2PWT; CONN-SMD_2P-P1.25_MEGASTAR_ZX-MX1.25-2PWT
D1, D2, D3, D4, D5, D6, D7, D8, D9, D10, D11, D12, D13, D14, D15, D16, D17, D18, D19, D20, D21, D22, D23, D24, D25, D26, D27, D28, D29, D30, D31, D32, D33, D34, D35, D36, D37, D38, D39, D40, D41, D42, D43, D44, D45, D46, D47, D48, D49, D50: 1n4148ws_c7420319; SOD-323_L1.7-W1.3-LS2.5-FD
D51, D52: h5vl10b; SOD-882_L1.0-W0.6-BI
D53, D54: ss14l; SOD-123F_L2.8-W1.8-LS3.7-RD
FPC1: fpc-05fb-40ph20; FPC-SMD_40P-P0.50_XUNPU_FPC-05FB-40PH20
K1, K2: RST; SW-SMD_L3.9-W3.0-P4.45
L1: 2.2uH; L0603
LED1: XL-1608PGC-06; LED0603-RD_RED
LED2: XL-1608SURC-06; LED0603-RD_RED
Q1: 8205A; TSSOP-8_L4.4-W3.0-P0.65-LS6.4-BL
Q2: 8050; SOT-23-3_L2.9-W1.3-P1.90-LS2.4-BR
R1, R2, R12, R18, R20: 1K; R0603
R3, R9, R10, R11, R22: 10k; R0603
R4: 2.4K; R0603
R5, R8: 5.1K; R0603
R6, R7: 0R; R0603
R13: 100R; R0603
R14: 487K; R0402
R15: 86.6K; R0402
R16, R17: 100K; R0402
R19: 10R; R0603
R21: 1k; R0603
SW1: mk-12c02-g020; SW-SMD_MK-12C02-G020
SW2, SW3, SW4, SW5, SW6, SW7, SW8, SW9, SW10, SW11, SW12, SW13, SW14, SW15, SW16, SW17, SW18, SW19, SW20, SW21, SW22, SW23, SW24, SW25, SW26, SW27, SW28, SW29, SW30, SW31, SW32, SW33, SW34, SW35, SW36, SW37, SW38, SW39, SW40, SW41, SW42, SW43, SW44, SW45, SW46, SW47, SW48, SW49, SW50, SW51: ts-1187s-20; SW-SMD_4P-L5.1-W5.1-P3.70-LS6.4
TP1, TP2, TP3, TP4, TP5, TP6, TP7, TP8, TP9, TP10, TP11, TP12, TP13, TP14, TP15: Test; TP
U1: TP4056; ESOP-8_L4.9-W3.9-P1.27-LS6.0-BL-EP
U2: esp32-s3-wroom-1u-n16r8; WIRELM-SMD_ESP32-S3-WROOM-1U
U3: DW01HA; SOT-23-6_L2.9-W1.6-P0.95-LS2.8-BR
U4: RT6150AGQW; WDFN-10_L3.0-W3.0-P0.50-BL-EP
USB1: MC-121-L124; USB-C-SMD_HANBO_MC-121-L124

Connections:
BOOT: K2.1, TP6.1, U2.27
CSX/SPI_CS: FPC1.9, TP9.1, U2.31
DCX/SPI_SCLK: FPC1.10, TP10.1, U2.32
G2: Q1.5, U3.3
GND: C1.1, C2.2, C3.2, C4.1, C5.1, C6.2, C8.1, C9.1, C10.2, CN1.3, CN1.4, D51.2, D52.2, FPC1.5, FPC1.12, FPC1.16, FPC1.37, FPC1.38, FPC1.41, FPC1.42, K1.1, K2.2, Q1.6, Q1.7, Q2.2, R4.1, R5.2, R8.2, R10.2, R12.1, R15.1, R17.1, R22.2, SW1.4, SW1.5, SW1.6, SW1.7, TP4.1, U1.1, U1.3, U1.9, U2.1, U2.40, U2.41, U4.3, U4.9, U4.11, USB1.13, USB1.14, USB1.A1B12, USB1.B1A12
IM1: FPC1.39, R18.2
IM2: FPC1.40, R20.2
IO1: FPC1.15, U2.39
IO2: R21.2, U2.38
IO4: SW2.2, U2.4
IO5: SW3.2, U2.5
IO6: SW4.2, U2.6
IO7: SW5.2, U2.7
IO8: SW10.2, U2.12
IO9: D1.2, D2.2, D3.2, D4.2, D5.2, D6.2, D7.2, D8.2, D9.2, D10.2, U2.17
IO10: SW11.2, U2.18
IO11: D41.2, D42.2, D43.2, D44.2, D45.2, D46.2, D47.2, D48.2, D49.2, D50.2, U2.19
IO15: SW6.2, U2.8
IO16: SW7.2, U2.9
IO17: SW8.2, U2.10
IO18: SW9.2, U2.11
IO21: D11.2, D12.2, D13.2, D14.2, D15.2, D16.2, D17.2, D18.2, D19.2, D20.2, U2.23
IO40: FPC1.11, TP11.1, U2.33
IO41: FPC1.13, TP12.1, U2.34
IO42: FPC1.14, TP13.1, U2.35
IO47: D21.2, D22.2, D23.2, D24.2, D25.2, D26.2, D27.2, D28.2, D29.2, D30.2, U2.24
IO48: D31.2, D32.2, D33.2, D34.2, D35.2, D36.2, D37.2, D38.2, D39.2, D40.2, U2.25
LED_A: C4.2, C5.2, C8.2, C9.2, FPC1.6, FPC1.7, FPC1.33, R3.1, R9.1, R11.1, R14.2, R18.1, R20.1, TP3.1, U2.2, U4.1
LED_K: FPC1.34, FPC1.35, FPC1.36, R19.2
NetC7_1: C7.1, R13.1, U3.5
NetD1_1: D1.1, SW2.3
NetD2_1: D2.1, SW3.3
NetD3_1: D3.1, SW4.3
NetD4_1: D4.1, SW5.3
NetD5_1: D5.1, SW6.3
NetD6_1: D6.1, SW7.3
NetD7_1: D7.1, SW8.3
NetD8_1: D8.1, SW9.3
NetD9_1: D9.1, SW10.3
NetD10_1: D10.1, SW11.3
NetD11_1: D11.1, SW12.3
NetD12_1: D12.1, SW13.3
NetD13_1: D13.1, SW14.3
NetD14_1: D14.1, SW15.3
NetD15_1: D15.1, SW16.3
NetD16_1: D16.1, SW17.3
NetD17_1: D17.1, SW18.3
NetD18_1: D18.1, SW19.3
NetD19_1: D19.1, SW20.3
NetD20_1: D20.1, SW21.3
NetD21_1: D21.1, SW22.3
NetD22_1: D22.1, SW23.3
NetD23_1: D23.1, SW24.3
NetD24_1: D24.1, SW25.3
NetD25_1: D25.1, SW26.3
NetD26_1: D26.1, SW27.3
NetD27_1: D27.1, SW28.3
NetD28_1: D28.1, SW29.3
NetD29_1: D29.1, SW30.3
NetD30_1: D30.1, SW31.3
NetD31_1: D31.1, SW32.3
NetD32_1: D32.1, SW33.3
NetD33_1: D33.1, SW34.3
NetD34_1: D34.1, SW35.3
NetD35_1: D35.1, SW36.3
NetD36_1: D36.1, SW37.3
NetD37_1: D37.1, SW38.3
NetD38_1: D38.1, SW39.3
NetD39_1: D39.1, SW40.3
NetD40_1: D40.1, SW41.3
NetD41_1: D41.1, SW42.3
NetD42_1: D42.1, SW43.3
NetD43_1: D43.1, SW44.3
NetD44_1: D44.1, SW45.3
NetD45_1: D45.1, SW46.3
NetD46_1: D46.1, SW47.3
NetD47_1: D47.1, SW48.3
NetD48_1: D48.1, SW49.3
NetD49_1: D49.1, SW50.3
NetD50_1: D50.1, SW51.3
NetD53_1: D53.1, D54.1, SW1.2, SW1.3
NetL1_1: L1.1, U4.2
NetL1_2: L1.2, U4.4
NetLED1_1: LED1.1, R1.2
NetLED2_1: LED2.1, R2.2
NetQ1_1: Q1.1, Q1.8
NetQ1_4: Q1.4, U3.1
NetQ2_1: Q2.1, R21.1, R22.1
NetQ2_3: Q2.3, R19.1
NetR1_1: R1.1, U1.6
NetR2_1: R2.1, U1.7
NetR4_2: R4.2, U1.2
NetR5_1: R5.1, USB1.A5
NetR6_1: R6.1, USB1.A7, USB1.B7
NetR7_2: R7.2, USB1.A6, USB1.B6
NetR8_1: R8.1, USB1.B5
NetR9_2: R9.2, U2.15
NetR10_1: R10.1, U2.16
NetR11_2: R11.2, U2.26
NetR12_2: R12.2, U3.2
NetR14_1: R14.1, R15.2, U4.10
NetR16_2: R16.2, U4.6
NetR17_2: R17.2, U4.7
NetSW2_1: SW2.1, SW12.2
NetSW3_1: SW3.1, SW13.2
NetSW4_1: SW4.1, SW14.2
NetSW5_1: SW5.1, SW15.2
NetSW6_1: SW6.1, SW16.2
NetSW7_1: SW7.1, SW17.2
NetSW8_1: SW8.1, SW18.2
NetSW9_1: SW9.1, SW19.2
NetSW10_1: SW10.1, SW20.2
NetSW11_1: SW11.1, SW21.2
NetSW12_1: SW12.1, SW22.2
NetSW13_1: SW13.1, SW23.2
NetSW14_1: SW14.1, SW24.2
NetSW15_1: SW15.1, SW25.2
NetSW16_1: SW16.1, SW26.2
NetSW17_1: SW17.1, SW27.2
NetSW18_1: SW18.1, SW28.2
NetSW19_1: SW19.1, SW29.2
NetSW20_1: SW20.1, SW30.2
NetSW21_1: SW21.1, SW31.2
NetSW22_1: SW22.1, SW32.2
NetSW23_1: SW23.1, SW33.2
NetSW24_1: SW24.1, SW34.2
NetSW25_1: SW25.1, SW35.2
NetSW26_1: SW26.1, SW36.2
NetSW27_1: SW27.1, SW37.2
NetSW28_1: SW28.1, SW38.2
NetSW29_1: SW29.1, SW39.2
NetSW30_1: SW30.1, SW40.2
NetSW31_1: SW31.1, SW41.2
NetSW32_1: SW32.1, SW42.2
NetSW33_1: SW33.1, SW43.2
NetSW34_1: SW34.1, SW44.2
NetSW35_1: SW35.1, SW45.2
NetSW36_1: SW36.1, SW46.2
NetSW37_1: SW37.1, SW47.2
NetSW38_1: SW38.1, SW48.2
NetSW39_1: SW39.1, SW49.2
NetSW40_1: SW40.1, SW50.2
NetSW41_1: SW41.1, SW51.2
RESET: C6.1, K1.2, R3.2, TP5.1, U2.3
RXD: TP15.1, U2.36
TXD: TP14.1, U2.37
USB5V: C1.2, C3.1, D54.2, LED1.2, LED2.2, TP1.1, U1.4, U1.8, USB1.A4B9, USB1.B4A9
USB_D+: D52.1, R7.1, TP8.1, U2.14
USB_D-: D51.1, R6.2, TP7.1, U2.13
VBAT1+: C10.1, R16.1, SW1.1, U4.5, U4.8
VBAT+: C2.1, CN1.1, D53.2, R13.2, TP2.1, U1.5
VSS: C7.2, CN1.2, Q1.2, Q1.3, U3.6
