netsecdevio/NeoCalculator/(commit log)

2026-10-07 feat(units): support affine temperatures and temperature differences
    Add exact affine temperature points and linear temperature differences
    across Calculation, Toolbox, FORMAT, Ans, history and session variables.
    Preserve point/difference identity through conversion, reject undefined
    affine operations, and support Kelvin, Celsius, Fahrenheit, Rankine and
    Réaumur with exact scale/offset metadata.
2026-11-02 hardware: add Rev A (alpha) PCB and enclosure design files
    Early, non-final hardware release published for transparency and review.
    - hardware/pcb: KiCad 10 schematic and board layout, schematic and
    board-outline PDFs, JLCPCB Gerbers, BOM and pick-and-place.
    - hardware/enclosure: 3D-printed case STLs and assembly instructions.
    - hardware/README.md: alpha warning, contents, CERN-OHL-S-2.0 license
    and credits (enclosure by Charles Baynes).
    - README.md: one-line link to hardware/README.md under Hardware.
    [case-bottom.stl, case-top.stl, display-shim.stl, key.stl, neocalculator-bom.xlsx, neocalculator.kicad_pcb, neocalculator.kicad_sch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]
